CapraRozalie/Multi-Layer-Liquid-Dispensing-System-/README.md

improved version of the documentation WIP
