CapraRozalie/Multi-Layer-Liquid-Dispensing-System-/3dmodels/base_hex.3mf

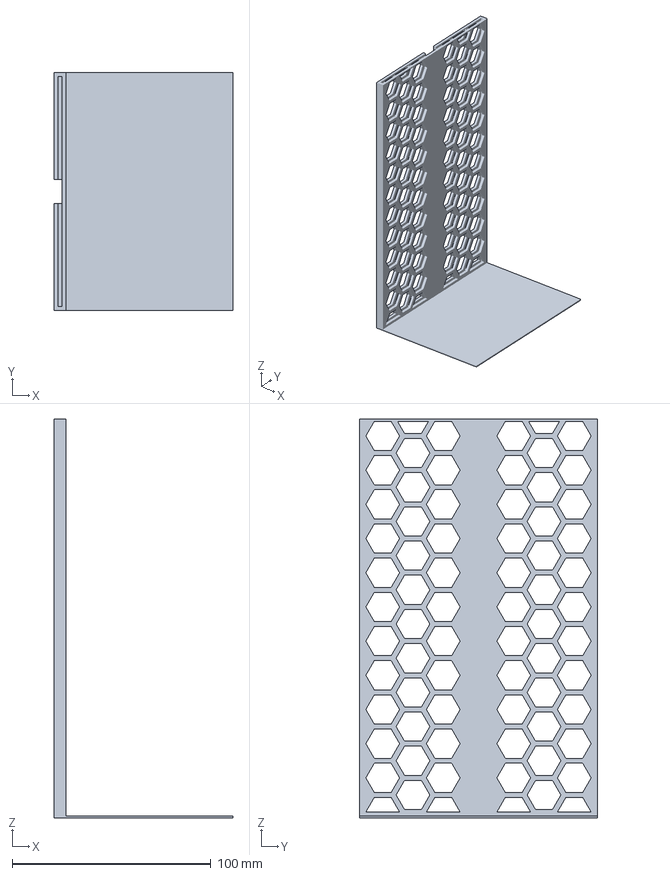
[picture p15: CAD file, 2026-03-17]
3dmodels/base_hex.3mf
90.0 x 120.0 x 201.0 mm
