CapraRozalie/Multi-Layer-Liquid-Dispensing-System-/3dmodels/up.3mf

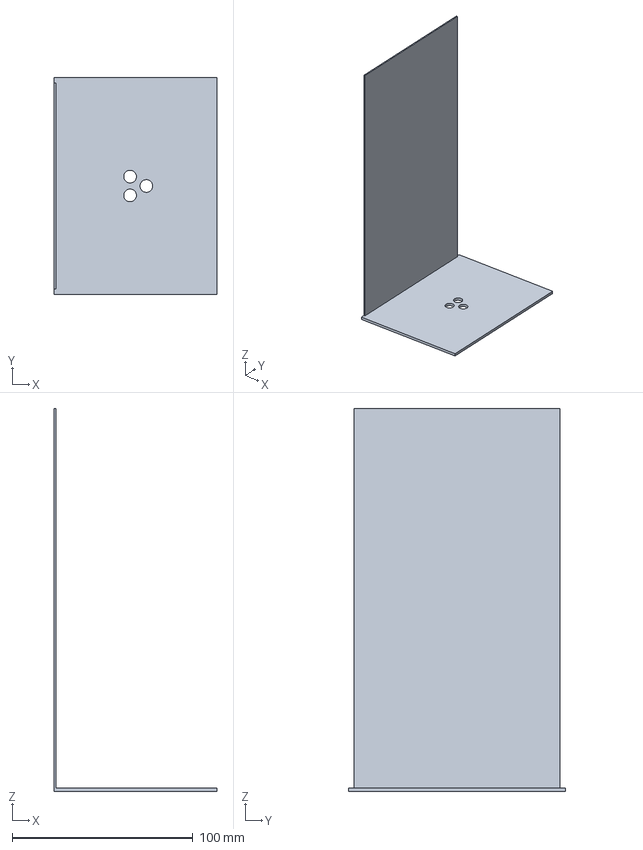
[picture p16: CAD file, 2026-03-17]
3dmodels/up.3mf
90.0 x 120.0 x 212.0 mm
