CapraRozalie/Multi-Layer-Liquid-Dispensing-System-/3dmodels/rackd-InvoluteRack.3mf

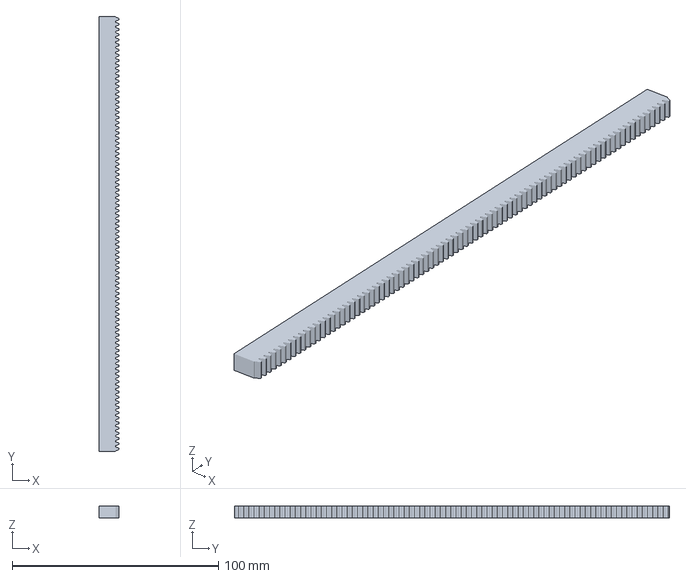
[picture p17: CAD file, 2026-03-17]
3dmodels/rackd-InvoluteRack.3mf
9.80 x 211.1 x 6.00 mm
