CapraRozalie/Multi-Layer-Liquid-Dispensing-System-/3dmodels/nozzle.3mf

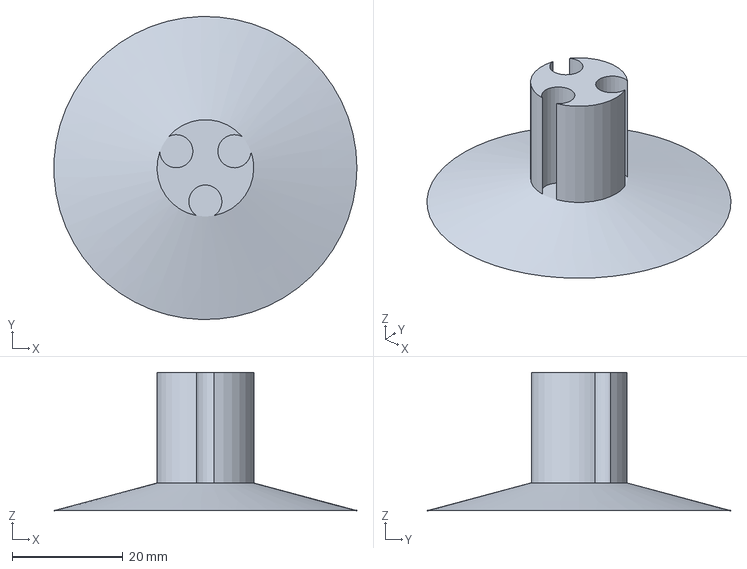
[picture p18: CAD file, 2026-03-17]
3dmodels/nozzle.3mf
54.8 x 54.8 x 25.0 mm
