CapraRozalie/Multi-Layer-Liquid-Dispensing-System-/3dmodels/pin_64_1.la1cred-Body.3mf

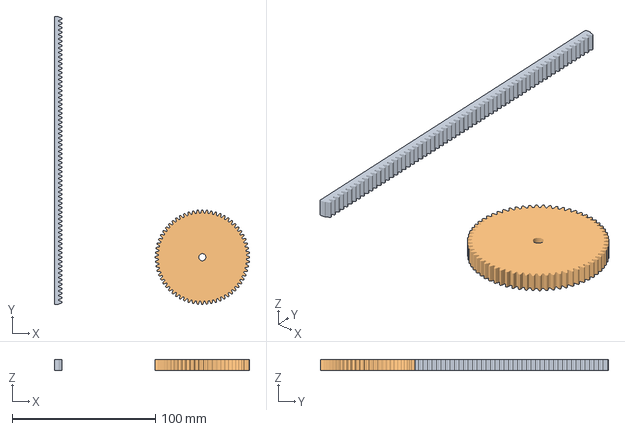
[picture p19: CAD file, 2026-03-17]
3dmodels/pin_64_1.la1cred-Body.3mf
136.2 x 201.1 x 8.00 mm
